holla2040/TDisplayS3-PIC18K22-Flasher/(commit log)

2026-10-13 Add design spec and implementation plan
    T-Display S3 production flasher for PIC18(L)F2x/4xK22 over HV ICSP,
    driven by a text script on FFat; keeps each board's EEPROM as
    settings-<userid>.hex across a full chip erase.
2026-10-13 Add HV ICSP wire layer and K22 device layer
2026-10-13 Add README, architecture notes and wiring diagram
2026-10-13 Fix review findings, switch MCLR drive to MOSFETs, power VPP from on-board boost
    - Default flash.txt writes the user ID last, so an interrupted run leaves it
    blank and the rerun stops at "blank userid" instead of overwriting settings.
    - Preflight rejects a write carrying user-ID bytes followed by a later user-ID
    write ("firmware has userid"); HEX checked against part sizes before any
    device call; device ID checked at start and on verify mismatch.
    - Auto mode: flashedId is the ID the run started on (no post-run probe);
    3-miss debounce and 2-probe new-board rule.
    - MCLR drive uses AO3400A / AO3401A SOT-23 MOSFETs; R1/R3/R5/R6 1 kOhm.
    - VPP comes from an on-board 5 V to 8.5 V boost; USB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
    [TDisplayS3-PIC18K22-Flasher.ino, config.h, icsp.cpp, icsp.h, pic18k22.cpp, pic18k22.h, script.cpp, script.h]
2026-10-13 Document low-voltage programming (LVP) wiring and protocol
    README section with an LVP wiring diagram (docs/wiring-lvp.*) and the
    DS41398B entry/exit sequence. The jig firmware is still HV only.
    Corrects the old claim that LVP needs MCLRE: MCLR is always enabled
    in LVP mode.
2026-10-13 Make LVP the documented mode for Trace boards; 5-pin ICSP header
    LVP wiring is five wires with GPIO3 driving MCLR directly (no Q1, no
    target MCLR pull-up). Both drawings show the 5-pin header (Trace R0: J7).
    Records the R0 config read (LVP = 1, MCLRE = 0) and the R0 pin-2
    back-feed into the U6 LDO. LVP entry is still not in icsp.cpp.
    Claude-Session: https://claude.ai/code/session_01P4kXRFnuu2fvJDaHSmDL4L
2026-10-14 Add LVP programming as the default; manual mode by default
    icsp.cpp gets an LVP entry/exit (key 4D434850h MSb first, GPIO3 driving
    MCLR directly) selected by ICSP_LVP in config.h (default 1); the HV
    driver stays under ICSP_LVP 0. Preflight refuses a write whose CONFIG4L
    clears LVP ("hex clears LVP"), with a host test.
    The jig starts in manual mode: it probes once at boot and before each
    run, runs only from KEY or POST /run, and no longer resets a running
    target once a second. Auto mode (BOOT short press) is unchanged.
    Tested on Trace R0 boards (PIC18F46K22): probe, read, erase, write,
    verify and reset over LVP; blink and LED images programmed by the jig run
    and read back byte-identical. Do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
    [TDisplayS3-PIC18K22-Flasher.ino, config.h, icsp.cpp, icsp.h, script.cpp]
2026-10-14 Accept compact binary (.pbin) and gzipped files; LVP on is mandatory
    The jig now reads .pbin ("PICB", [u32 addr][u16 len][data]..., CRC32)
    as well as Intel HEX, picking the format from the file's first bytes,
    and inflates gzip files with the ESP32-S3 ROM tinfl (decompressor on
    the heap) after checking the gzip CRC. Scripts name .hex, .pbin or
    .pbin.gz the same way. tools/hex2pbin.py converts a HEX and refuses one
    without CONFIG4L or with LVP off. R4 at -O0: 45 KB HEX -> 9 KB .pbin.gz.
    Tested on a Trace R0 board: R4 firmware at -O0 and -O1 written and
    verified from .hex, .pbin and .pbin.gz. Host test for the .pbin parser
    and CRC32. CLAUDE.md: never compile or flash firmware without LVP = ON.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
